3247786840-design/chenbai/微负压系统数学建模.md

# 微负压闭环气动系统 —— 数学建模报告

> 对象：硬件成本 <500 元的闭环微负压气动原型（非医疗器械，纯工程台架验证）
> 目标：正常维持 **15–20 mmHg**；任何单点/复合故障下，物理层将负压钳位在 **25 mmHg** 以内
> 方法：等温集总参数模型 + 解析设计定律 + 数值仿真（`model.py`，输出 `figs/*.png`）

---

## 1. 建模目标与范围

| 问题 | 建模回答 |
|---|---|
| 闭环能否把压力锁在 15–20 mmHg？ | 滞环与 PI-PWM 两种控制器的带内性能、泄漏负载下的占空比 |
| 四层防线是否数学上自洽？ | 每层给出触发条件的数学表达 + 故障注入仿真证据 |
| 三重灾难（MCU死机+继电器粘连+传感器短路）下 25 mmHg 红线是否守得住？ | 机械泄压阀的稳态钳位公式与选型反例 |
| 缓冲瓶"空间换容错"的定量收益？ | 时间定律 $t=V\Delta p/(P_{atm}Q)$ 及缓冲瓶选型曲线 |
| 断电/掉线后多快回到常压？ | 泄放时间常数与口径选型 |

不覆盖：生物学效应、人体实验、成本 BOM、PCB 实现。

---

## 2. 假设与符号

**假设**

1. **等温过程**：气路各处温度=环境温度。依据：腔体小、壁面换热快、压力变化率低（≤30 mmHg/s ≪ 1 atm/s），温升引起的附加压力 <1%。
2. **理想气体、集总参数**：每腔内压力瞬时均匀。依据：声速远快于控制时间尺度；罩杯↔缓冲瓶耦合时间常数 $\tau_{eq}\approx 1.8\ \text{ms}$（见 §4.2），远小于秒级控制动态。
3. **准稳态元件**：阀/泵/泄漏无动态（弹簧质量、电磁延迟 ≪ 控制周期）。
4. **表压表述**：$p$ 以大气压为零点，**负值=负压**；$|p|=20\ \text{mmHg}$ 即负压 20 mmHg。
5. 泵在微负压段（|p| ≤ 60 kPa ≪ 101.3 kPa）近似**恒体积流量**，仅在接近极限真空时线性降额。

**符号表**

| 符号 | 含义 | 基准值 |
|---|---|---|
| $P_{atm}$ | 大气压 | 101 325 Pa |
| $p$ | 表压（负=负压） | Pa |
| $V_c, V_b$ | 罩杯 / 缓冲瓶容积 | 0.3 L / 1 L |
| $Q_p$ | 泵抽速 | 3 L/min = 5×10⁻⁵ m³/s |
| $R_{cb}$ | 罩杯–缓冲瓶管路层流阻力 | 8×10⁵ Pa·s/m³（4 mm×30 cm） |
| $K_l$ | 密封泄漏孔口系数 | 1.614×10⁻⁸（标称 50 ml/min @ 20 mmHg） |
| $p_{crack}, K_r$ | 泄压阀起跳压力 / 流导 | 24 mmHg / 4.8×10⁻⁶ m³/(s·Pa^0.5) |
| $R_{vent}$ | 断电泄放路径阻力 | 6×10⁶ Pa·s/m³（τ≈77 ms） |
| $p_{ult}$ | 泵极限真空 | −60 kPa |
| 1 mmHg | — | 133.322 Pa |

---

## 3. 基础方程与元件模型

### 3.1 腔室压力动力学（核心方程）

由理想气体状态方程 $P_{abs}V=nRT$，等温下对时间求导：

$$V\frac{d(P_{atm}+p)}{dt}=RT\frac{dn}{dt}$$

把流入体积流量 $Q$（折算到大气密度，流入为正）换算为摩尔流量 $\dot n=\dfrac{P_{atm}}{RT}Q$，代入得**集总腔室方程**：

$$\boxed{\;V\frac{dp}{dt}=P_{atm}\sum Q_{in}\;}$$

物理含义：压力变化率 = 流量 × 大气压 / 容积——**容积越大，同样的泄漏/抽气引起的压力变化越慢**，这是全文所有"空间换时间"结论的根。

### 3.2 流阻与孔口

- 层流（管路耦合）：$Q=\Delta p/R$
- 孔口/湍流（泄漏、泄压阀、泄放）：$Q=K\sqrt{\Delta p}$（由 $Q=C_d A\sqrt{2\Delta p/\rho}$ 归并常数）

### 3.3 元件模型

**(a) 真空泵（恒流源 + 极限降额）**

$$Q_{pump}(p)=Q_p\cdot\max\!\Big(0,\;1-\frac{p}{p_{ult}}\Big),\qquad p_{ult}=-60\ \text{kPa}$$

**(b) 罩杯密封泄漏（空气漏入）**

$$Q_{leak}=\lambda\,K_l\sqrt{-p}\quad (p<0),\qquad \lambda=\text{泄漏劣化倍数}$$

标定：$\lambda=1$ 时 20 mmHg → 50 ml/min；$\lambda=8$（湿度/位移劣化）→ 400 ml/min。

**(c) 机械泄压阀（第四层，纯机械）**

$$Q_{relief}=\begin{cases}K_r\sqrt{-p-p_{crack}}, & -p>p_{crack}\\[2pt] 0,&\text{否则}\end{cases}$$

即：负压未达起跳压力时完全密封；起跳后按过压量平方根从大气吸入。

**(d) 常开电磁阀支路（三态）**

| 状态 | 条件 | 缓冲瓶支路流量 |
|---|---|---|
| 抽气 | 阀开 + 泵开（PWM 导通相） | $-Q_{pump}(p_b)$ |
| 密封 | 阀关（PWM 截止相，耗电保持） | $0$ |
| 泄放 | 断电 → 阀弹簧复位导通大气 | $-p_b/R_{vent}$ |

**常开=断电即泄放**在模型中的表达：任何"断电"事件把支路切到 `vent`，系统按 $\tau=R_{vent}V/P_{atm}$ 指数回零。

---

## 4. 系统状态方程

### 4.1 两腔模型（基准）

$$\frac{dp_c}{dt}=\frac{P_{atm}}{V_c}\Big[\frac{p_b-p_c}{R_{cb}}+Q_{leak}(p_c)+Q_{relief}(p_c)\Big]$$

$$\frac{dp_b}{dt}=\frac{P_{atm}}{V_b}\Big[-\frac{p_b-p_c}{R_{cb}}+u_{branch}(p_b)\Big]$$

控制量 $u_{branch}\in$ {抽气, 密封, 泄放}。传感器测量 $p_c$（因 $\tau_{eq}$ 极小，$p_b\approx p_c$，单传感器足够）。

无缓冲瓶时退化为单腔：$\dfrac{dp_c}{dt}=\dfrac{P_{atm}}{V_c}\big[Q_{leak}+Q_{relief}-u\cdot Q_{pump}\big]$。

### 4.2 耦合时间常数验证

$$\tau_{eq}=\frac{R_{cb}}{P_{atm}\big(\tfrac{1}{V_c}+\tfrac{1}{V_b}\big)}=\frac{8\times10^5}{101325\times4333}\approx1.8\ \text{ms} \ll \text{控制周期}$$

→ 集总假设成立，双腔模型数值稳定要求 $dt<2\tau_{eq}$，仿真取 **dt = 0.5 ms**。

---

## 5. 解析设计定律（模型最重要的输出）

### 5.1 时间定律：缓冲瓶到底买来多少抢救时间？

泵全速、忽略泄漏时压力线性下降，到某阈值 $\Delta p$ 的时间：

$$\boxed{\;t=\frac{V\,\Delta p}{P_{atm}\,Q_p}\;}$$

代入基准（$V_c+V_b=1.3$ L，$Q_p=3$ L/min，0→25 mmHg）：

| 配置 | 满流量降压速率 | 0→25 mmHg | 20→23（看门狗窗口） |
|---|---|---|---|
| **无缓冲瓶**（0.3 L） | 127 mmHg/s | **0.20 s** | 24 ms |
| **1 L 缓冲瓶**（1.3 L） | 29 mmHg/s | **0.86 s** | 103 ms |
| 1 L + 泵降速 1 L/min | 9.7 mmHg/s | 2.6 s | 0.31 s |
| 1 L + 泵降速 0.3 L/min | 2.9 mmHg/s | 8.6 s | 1.0 s |

> ⚠️ **对设计文档的重要修正**：1 L 缓冲瓶在 3 L/min 泵下的真实抢救时间是 **0.86 s，而非"数秒至数十秒"**（见 `fig6` 左图）。要兑现"数秒"，必须 **泵降速到 0.3–1 L/min**（首选，泄漏负载允许）或缓冲瓶加大到 ~5 L+。选型见 §9。
> 泵降速可行性校核：最恶劣泄漏 400 ml/min < 泵 1 L/min → 稳态占空比 40%，可行 ✓（若泵 <400 ml/min 则无法压制劣化泄漏，**密封质量与泵速是同一组约束**）。

舒适性推论：压力满速率仅 **29 mmHg/s**（1.3 L 时），压力变化平缓，皮肤拉扯感可控。

### 5.2 机械泄压阀钳位公式（第四层的定量表述）

泵全速 + 泄压阀全开时的稳态：$Q_p=Q_{leak}+Q_{relief}\approx Q_{relief}$，解出过压量：

$$\boxed{\;p_{clamp}=p_{crack}+\Big(\frac{Q_p}{K_r}\Big)^2\;}$$

**这是泄压阀选型的强制规范**：不是"起跳=25 就安全"，而是"起跳 + 全流量背压 ≤ 25"。

| 方案 | 起跳 | $K_r$ | 全流量背压 | 稳态钳位 | 判定 |
|---|---|---|---|---|---|
| **推荐** | 24 mmHg | 4.8×10⁻⁶ | 0.8 mmHg | **24.8** | ✓ 留 0.2 mmHg 余量 |
| 文档字面 | 25 mmHg | 2.5×10⁻⁶ | 3.0 mmHg | **27.5** | ✗ **越过红线** |
| 修正 | 23.5 mmHg | 2.5×10⁻⁶ | 3.0 mmHg | 26.5 | ✗ 仍越线 |
| 修正 | 23 mmHg | 4.8×10⁻⁶ | 0.8 mmHg | 23.8 | ✓ 但正常运行易误喷 |

仿真验证（`fig3`）：推荐方案钳位 **24.70 mmHg**，错误方案 **27.53 mmHg**，与解析值 24.8 / 27.5 吻合（差异来自泄漏分流）。
**★ 真实弹簧阀口径修订（`sim_upgrade.py` [B][C][D] 校核后）：**

1. 上式是"理想阀"口径（阀芯无惯性、开度瞬时到位）。加入弹簧-质量-阻尼阀芯后
   （`sim_upgrade.py` D 段，m=2 g、预压行程 x₀），两方程消元得**真实稳态过压**：

$$\overline{p}=\left(\frac{p_{crack}}{x_0/x_{max}}\cdot\frac{Q_p}{K_r\sqrt{p}}\right)$$

   现行 $K_r=4.8\times10^{-6}$（Ø2.8 阀座）在该口径下平衡点 = **27.8 mmHg > 25 越线**
   （数值 27.77 / 解析 28.09 双重确认，`fig10`）；要求全流量过压 ≤1 mmHg 需
   **$K_r\ge2.1\times10^{-5}$，推荐 $4.5\times10^{-5}$（Ø6–8 阀座）→ 钳位 24.4 ✓**，
   0.25 s 稳定、无颤振（阀芯固有频率 22–49 Hz ≫ PWM 2 Hz，无共振）。
2. 蒙特卡洛（N=20 000，起跳公差 ±0.5、$K_r$/泵速 ±10% 散布，`fig9`）：
   起跳 24.0±0.5 → 钳位 24.85±0.56，**P(>25)=39.2%**；
   收紧 **23.0±0.5 → 23.85±0.56，P(>25)=2.3%，P95=24.78**。
3. 因此定型规格修订为：**起跳 $p_{crack}=23.0\pm0.5$ mmHg + $K_r\ge2.1\times10^{-5}$**——
   弹簧公差与阀口流导必须联合校核，单看任一口径都会漏判。

### 5.3 泄漏负载 → 泵占空比

稳态占空比 $D=\lambda K_l\sqrt{|p|}/Q_p$：

| 工况 | 泄漏 @17.5 mmHg | 所需占空比（泵 3 L/min） |
|---|---|---|
| 标称密封 | 47 ml/min | **1.6%** |
| 劣化 ×8 | 374 ml/min | **12.9%** |

仿真（`fig2`）实测 1.6% / 12.9%，完全一致。**密封质量直接决定泵速下限**（见 §5.1）。

### 5.4 开环固定占空比为什么必然越线

满流量 29 mmHg/s ⇒ **PWM 开 1 s = 冲 29 mmHg**，从环境压出发约 0.82 s 穿看门狗 23、约 0.85 s 穿 24 mmHg：

- 电子防线健全：0.82 s 被看门狗截断（`fig5` 橙线）；
- 电子全失效：被机械阀锁在 24.7 mmHg 高位锯齿（`fig5` 红线）——**安全但长期处于危险区边缘**；
- 闭环截断脉冲：稳定 15–20（蓝线）。

结论：**"开1秒关3秒"只能作为闭环内的脉冲形状，绝不能作为开环固定节拍**——这在数学上支持了设计文档"开环必漂移"的判断，且比"漂移"更严重：是**单向冲顶**。

### 5.5 断电泄放时间常数

$$\tau=\frac{R_{vent}(V_c+V_b)}{P_{atm}},\qquad |p|(t)=|p_0|e^{-t/\tau}$$

选 $R_{vent}=6\times10^6$ → τ=77 ms → 从 17.5 mmHg 到 <1 mmHg 用时 **222 ms**（仿真 `fig4a` 实测 222 ms ✓）。
若要求"90% 泄放在 0.1 s 内"：$\tau\le43$ ms → $R_{vent}\le3.3\times10^6$ → 初始泄放峰值流量 48 L/min（等效通径 ~5 mm，1/4″ 常开阀即可满足）。

### 5.6 传感器短路的"隐身"与看门狗盲区

传感器短路读 −5 mmHg 恒值 → 第一、二层（都吃这个读数）**全部失效**，系统只能靠第四层。仿真（`fig3` 灰点划线）：真实压力 24.7 mmHg 时读数仍 5 mmHg，看门狗 `L2触发=False` ✓。
→ 防线设计推论：看门狗除阈值外必须做**合理性窗口检查**（如读数恒定方差≈0、或落在 −5~+5 mmHg 之外）；但即使看门狗被骗，**第四层不依赖任何电子量**。

---

## 6. 四层安全防线的数学表达

| 层 | 触发条件（数学） | 执行 | 故障注入仿真结果 |
|---|---|---|---|
| ① 软件闭环 | 滞环：$\|p\|\ge20$ 密封 / $\|p\|<15$ 抽气；或 PI：$u=\text{clip}(K_p e+K_i\!\int\! e)$，$e=17.5-\|p\|$ | PWM 截断脉冲 | 带内 15.00–20.05（滞环）、17.32–17.63（PI 标称），恶化后 15.00–20.04 / 16.39–18.66；见 `fig2` |
| ② 独立看门狗 | $\|p_{meas}\|>23$ 或传感器掉线/超量程 | 切断总电源 | 掉线 0.5 ms 内截断→213 ms 回常压（`fig4b`）；开环冲顶 820 ms 截断（`fig5`） |
| ③ 常开阀断电泄放 | 断电（任意原因）→ 支路切 `vent` | 弹簧复位导通大气 | τ=77 ms，222 ms 到 <1 mmHg（`fig4a`） |
| ④ 机械泄压阀 | $-p>p_{crack}=24$ mmHg，纯力学平衡 $F_{气}=F_{弹簧}$ | 大气强行涌入 | 复合灾难下钳位 24.70 mmHg < 25（`fig3`） |

**故障树（顶事件：罩杯 |p|>25 mmHg 持续）的最小割集**：

1. {继电器粘连 ∧ MCU 死机 ∧ 传感器短路} → 前三层全盲 → **仅④拦截：仿真钳位 24.70 ✓**（前提是 §5.2 选型规范，这是**强制项**）
2. {断电} → ③ 拦截：222 ms 回零 ✓
3. {传感器掉线} → ② 拦截：0.5 ms 截断 ✓
4. {开环固定占空比} → ①② 拦截，② 失效时 ④ 兜底 24.7 ✓，但属**设计违规**（禁止纯开环）

---

## 7. 数值仿真结果汇总

（`python model.py`，dt=0.5 ms，显式欧拉；参数=§2 基准）

| # | 场景 | 关键结果 |
|---|---|---|
| 1 | 正常滞环 + 120 s 泄漏×8 | 带内 **15.00–20.05**；占空比 1.6%→12.9%；看门狗未触发 |
| 2 | 正常 PI-PWM 同工况 | 标称 **17.32–17.63**；恶化后 **16.39–18.66** 仍在带内；占空比 1.7%→12.9% |
| 3 | 三重灾难（1 L 缓冲+合格阀） | 202 ms 到 23、**239 ms 到 24**、钳位 **24.70**；读数恒 5，看门狗隐身 |
| 4 | 三重灾难（无缓冲瓶） | **46 ms 到 23、55 ms 到 24**、钳位 24.70（④仍守住，但但②③已无时间反应） |
| 5 | 三重灾难（泄压阀选型错误） | 钳位 **27.53 > 25 ✗** → 证明 §5.2 规范的必要性 |
| 6 | 断电泄放 | τ=77 ms，**222 ms** 到 <1 mmHg |
| 7 | 传感器掉线 | 看门狗 **≤1 采样周期**截断，213 ms 到 <1 mmHg |
| 8 | 开环 1s/3s PWM，无电子防线 | **≈0.85 s 冲 24**，被机械阀锁在 22.5–24.7 锯齿（长期危险区边缘） |
| 9 | 开环 + 看门狗有效 | 820 ms 在 23 mmHg 截断回零 |
| 10 | 闭环对照 | 峰值 20.1，稳定带内 |

图表：`fig1` 拓扑与四层防线 · `fig2` 正常闭环 · `fig3` 灾难钳位 · `fig4` 断电/掉线 · `fig5` 开环危险性 · `fig6` 设计曲线。

---

## 8. 设计图表解读（fig6）

**左图（空间换时间定律）**：横轴总容积、纵轴 0→25 mmHg 时间（对数）。四条泵速曲线即 §5.1 表格的连续版。水平虚线 0.3 s = 看门狗可用窗口（100 Hz 采样）。基准点（1.3 L, 3 L/min）落在 0.86 s——高于窗口但**不足"数秒"**；把泵降到 1 L/min 即升到 2.6 s，落点即推荐设计。

**右图（泄压阀选型）**：三条起跳压力曲线随流导 $K_r$ 增大而逼近起跳值（背压→0）。红线 25 是硬约束：**任何曲线在设计点必须位于红线下方**。起跳 25 的曲线（红）永远压在红线上方→无解，只能把起跳降到 24（蓝曲线）并取 $K_r\ge4.8\times10^{-6}$。

---

## 9. 设计定型参数表

| 参数 | 定型值 | 依据 |
|---|---|---|
| 罩杯容积 $V_c$ | 300 ml | 题设 |
| 缓冲瓶 $V_b$ | **1 L**（下限 0.5 L） | 1.3 L 时 0.86 s；配合泵降速达"数秒" |
| 泵抽速 $Q_p$ | **0.5–1 L/min**（上限 3 L/min 时必须 100 Hz 看门狗） | §5.1 时间定律 + §5.3 泄漏压制 |
| 密封泄漏预算 | 标称 ≤50 ml/min @20 mmHg；必须容忍 ×8 劣化 | §5.3 占空比 13% 仍可行 |
| 泄压阀起跳 $p_{crack}$ | **23.0 ± 0.5 mmHg**（MC 校核：24±0.5 时 P(>25)=39%） | §5.2 真实阀+MC |
| 泄压阀流导 $K_r$ | **≥2.1×10⁻⁵，推荐 4.5×10⁻⁵（Ø6–8 阀座）**；4.8e-6 理想口径在动力学模型中钳位 27.8 越线 | §5.2 弹簧阀过压律 |
| 断电泄放 $R_{vent}$ | ≤6×10⁶（τ≤80 ms；要求 0.1 s/90% 则 ≤3.3×10⁶） | §5.5 |
| 看门狗 | 阈值 23 mmHg；采样 **≥100 Hz**；读数合理性窗口（防短路隐身） | §5.1/§5.6 |
| 控制器 | 滞环 15/20（简单可靠）或 PI（Kp=0.06, Ki=0.01, PWM 周期 0.5 s，脉冲按测量截断） | §7 场景 1–2 |
| 开环固定占空比 | **禁止** | §5.4 |

**安全结论**：在满足上表（尤其泄压阀两条强制规范——**规格已按 §5.2 真实阀口径与 MC 统计收紧：起跳 23.0±0.5、$K_r\ge2.1\times10^{-5}$**）的前提下，四层防线对所列全部故障组合提供冗余拦截；第 ④ 层不依赖任何电子量，是唯一在"三重灾难"下仍被仿真的防线，其钳位 24.70 mmHg（理想阀口径）/ 24.4 mmHg（真实阀口径）< 25 mmHg，且公式化了"为什么必须这么选型"。

---

## 10. 模型局限与后续工作（`sim_upgrade.py` 升级包已解决状态）

> 开源工具链：scipy `solve_ivp`(DOP853) / CoolProp 6.7.0 / numpy 蒙特卡洛 / 弹簧-阀芯动力学。

1. **等温假设 → ✅ 已量化**：CoolProp 实测全工况密度偏差 ≤0.50%（物性层成立）；
   双状态(质量+能量)热模型给出时间与漂移量级：泵故障到 24 mmHg 等温 239.5 ms vs
   绝热 171 ms（**等温偏保守 +29%，安全方向**）；密封相有限换热(τ=20s)热漂移
   **3.68 mmHg < 滞环预算 5 mmHg**，且泄漏同向进一步抵消（`fig8`）。
2. **泵特性 → ⚠ 仍建议实测**：恒流+线性降额近似保留；厂家 P-Q 曲线到位后替换
   `pump_flow()` 即可，其余结论对 Q 敏感度已由 MC 给出（±10% → 钳位 σ0.56 mmHg）。
3. **泄压阀动态 → ✅ 已建模并修订规格**：弹簧-质量-阻尼+开度流量耦合（`fig10`），
   0.25–0.62 s 稳定、无颤振、PWM 2 Hz ≪ 阀芯 22–49 Hz；**发现理想阀口径漏判**
   （真实平衡 27.8>25）→ §5.2/§9 规格已修订（K_r≥2.1e-5、起跳 23.0±0.5）。
4. **湍流/层流分区**：孔口律统一处理，低压差略偏保守（偏安全），保留。
5. **多物理耦合**：管路柔度未建模（实际更"慢"→偏安全），保留。
6. **传感噪声/统计 → ✅ 已纯仿真关闭**：MC 10k 覆盖起跳公差×流导×泵速×容积散布
   （`fig9`）：现行规格 P(>25)=**39.2%** → 收紧后 2.3%；看门狗窗口 3 L/min 有
   39.8% 概率 <100 ms、1 L/min 为 0%。噪声×量化×零漂抖振扫描（E 段，100ms
   节拍与固件一致）：基准/σ0.38/量化2.0/零漂1.0 各工况真值带 ≤22.6、启停次数
   与基准同量级 → 滞环鲁棒；单样本 σ0.94 出现罕见双误差毛刺顶到 ~24.5
   （触 L4 而非越 25），固件 16 点平均 σ÷4≈0.24 后消除 → **滤波为强制项**。
7. **数值自证 → ✅ 已交叉验证**：欧拉(dt=0.5 ms) vs scipy DOP853(rtol=1e-9)
   轨迹最大偏差 **0.41 Pa**，到 24 mmHg 时间与钳位完全一致 → 既有结果可信。
8. **可移植性**：`model.py` 纯 numpy 显式积分，可直接翻译为 MATLAB 或 C
   （MCU 端在环仿真）。

---

## 附录 A：复现方式

```bash
cd <本项目根目录>       # 克隆后切换到仓库根（含 model.py 的那一层）
python model.py        # 输出指标表 + figs/fig1..7
python sim_upgrade.py  # 升级包：交叉验证/热力学/MC/阀动态 → figs/fig8..10
```

依赖：Python ≥3.8，numpy、scipy、matplotlib（中文使用 Microsoft YaHei）；
可选 CoolProp ≥6.7（物性权威来源，缺失时回退其 300K 权威值）。

## 附录 B：关键公式速查

| 公式 | 用途 |
|---|---|
| $V\,dp/dt=P_{atm}Q$ | 一切压力动态的根 |
| $t=V\Delta p/(P_{atm}Q)$ | 缓冲瓶/泵速选型 |
| $p_{clamp}=p_{crack}+(Q_p/K_r)^2$ | 泄压阀起跳+流导选型 |
| $D=\lambda K_l\sqrt{|p|}/Q_p$ | 泵速下限 |
| $\tau=R\,V/P_{atm}$ | 断电泄放口径 |
| $\tau_{eq}=R_{cb}/[P_{atm}(1/V_c+1/V_b)]$ | 集总模型有效性 |
