3247786840-design/chenbai/通气实验方案.md

# 通气实验方案（台架版）

> **性质与红线**：本方案仅用于**台架通气验证**（密封气球 / 硅胶假体 / 注水模拟皮肤）。
> 严禁人体接触、严禁佩戴测试、严禁在无人看管下运行任何"故障注入"步骤（S3/S4/S6）。
> 判定基准为**仿真预测值**（`model.py` / `buffer_sweep.py` / `sim_upgrade.py`，已经
> scipy 独立求解器交叉验证）；容差按仪表分辨率与实测抽速不确定性给出，见各步注明。
> 记录表中的"实测"列在硬件到位后回填，最终与 README 台架数据表互相引用。

---

## 0. 器材与仪表

| 类别 | 清单 | 备注 |
|---|---|---|
| 被测件 | 打印件（转接头/瓶盖/外壳）、500ml 瓶、Ø80 硅胶罩杯、内4外6 医用硅胶管、常开电磁阀、微型真空泵、微差压传感器、机械泄压阀(起跳按 §9 修订规格 23.0±0.5)、ESP32 固件已烧录 | 打印材料仅限医用树脂/PETG |
| 仪表 | **机械真空表 0~-60 kPa（主判定表）**、电子数显负压表（辅助/记录）、秒表或手机 120fps 慢动作（计时）、温度计 | 机械表独立于被测电子链，是 S3/S4 的法定读数源 |
| 台架 | 密封气球/注水假体、亚克力隔离罩（故障注入步骤用）、急停断电开关、扎带/夹具 | 急停直接断泵继电器电源 |
| 记录 | 本文件记录表 + 原始数据截图/照片 | 每步留存原始数据 |

**通用条件**：室温 20–26 ℃；每步开始前设备静置 ≥5 min；每步之间断电复位回零。

---

## S0. 实测自标定（先做，用于修正后续所有时间判据）

**目的**：仿真时间公式 `t = V·Δp /(P_atm·Q)` 中 Q 是名义值（3 L/min），先实测。

**步骤**：
1. 泵直连机械表 + 量筒排水法（或秒表+流量计）测抽速：记录 60 s 内抽气水量 V_w；
   `Q_meas = V_w / 60 s`（换算到 L/min）。
2. 记录泵极限真空（堵死抽 30 s 读表）：应 ≈ **-60 kPa**。

**记录表**

| 项 | 名义值 | 实测 | 备注 |
|---|---|---|---|
| Q_p [L/min] | 3.0（或 0.5–1 规格） | | |
| 极限真空 [kPa] | -60 | | |

**后续时间类判据统一修正**：`t_预测 = t_表中值 × (3.0 / Q_meas)`。

---

## S1. 静态检漏

**步骤**：按装配图接好全气路（罩杯端封堵），泵抽至 **-40 kPa**，停泵关阀，静置 **60 s** 读表。

| 项 | 判据（来源） | 实测 | 判定 |
|---|---|---|---|
| 60 s 压降 | **< 1 kPa**（瓶盖装配说明/管路密封） | | ☐PASS ☐FAIL |
| 起始/终止读数 | 记录 | | |

---

## S2. 零点、量程与断电泄放

| 项 | 步骤摘要 | 判据（来源） | 实测 | 判定 |
|---|---|---|---|---|
| 大气零点 | 未抽气读电子+机械表 | **0 ± 1 mmHg**（FMEA B 节） | | ☐ |
| 断电泄放 | 抽至 -20 mmHg，运行中**拔总电**，慢动作计时 | 17.5→<1 mmHg：**≈222 ms**（τ≈77 ms，`fig4a`）；判据 **≤ 500 ms** | | ☐ |
| 常开阀确认 | 断电后阀位 | 必须通大气（断电=开），无残余负压 | | ☐ |

---

## S3. 泄压阀起跳与稳态钳位 ⚠ 故障注入（隔离罩内做）

**步骤**：出口全封、泵全速强抽，**以机械表为唯一法定读数**，用慢动作录像读起跳压力与平台；
重复 3 次取均值。每次后断电复位。

| 项 | 判据（来源） | 实测1/2/3 | 均值 | 判定 |
|---|---|---|---|---|
| 起跳压力 | **23.0 ± 0.5 mmHg**（§9 修订规格；MC 校核 P(>25)=2.3%） | | | ☐ |
| 稳态钳位 | **≤ 25 mmHg**，预测 **24.4**（`fig10`，K_r=4.5e-5 阀座 Ø6–8） | | | ☐ |
| 开阀稳定时间 | **≤ 1 s** 无持续颤振（预测 0.25 s） | | | ☐ |
| 若实测钳位 >25 | 判 FAIL → 阀座流导不足（§5.2 真实阀过压律），换阀重测 | | | |

---

## S4. 泵故障时限 ⚠ 故障注入（隔离罩内做）

**步骤**：模拟"死机+继电器粘连"：强电直连使泵持续全速，从 -17.5 mmHg 起计时（慢动作 120fps）。

| 项 | 判据（来源）×S0 修正 | 实测 | 判定 |
|---|---|---|---|
| 20→23 mmHg（看门狗窗口） | 3 L/min：**104 ms**（1L 瓶）；1 L/min：**311 ms**。`fig9` 显示 3 L/min 有 39.8% 概率 <100 ms → **若 Q_meas>2.5 L/min，必须泵侧节流或换 ≤1 L/min 泵** | | ☐ |
| 0→25 mmHg（无缓冲瓶） | **≈0.24 s ×修正**（`buffer_sweep`） | | ☐ |
| 0→25 mmHg（1L 缓冲瓶） | **≈0.86 s ×修正** | | | ☐ |
| 终点 | 被 S3 的泄压阀钳住，**不越过 25** | | ☐ |

---

## S5. 闭环带性能（正常工况）

**步骤**：正常供电闭环运行 10 min；随后注入泄漏（松开一处接头半圈）模拟 ×8 劣化再跑 10 min。
电子表记录全曲线。

| 项 | 判据（来源） | 实测 | 判定 |
|---|---|---|---|
| 标称带内 | **15.0–20.05 mmHg**（滞环，`fig2a`） | | ☐ |
| 泵占空比（标称） | **≈1.6%** | | ☐ |
| 泄漏×8 后带内 | **15.0–20.05 mmHg**，占空比 **≈12.9%** | | ☐ |
| 看门狗误触发 | **0 次** | | ☐ |
| PI 模式（可选） | 标称 17.3–17.6；×8 后 16.4–18.7（`fig2b`） | | ☐ |

---

## S6. 电子故障注入 ⚠（隔离罩内做）

| 项 | 注入方法（无需改固件） | 判据（来源） | 实测 | 判定 |
|---|---|---|---|---|
| 传感器掉线 | 拔传感器插头 | **≤1 采样周期**截断→断电泄放，回到 <1 mmHg **≈213 ms**（`fig4b`），红灯慢闪 | | ☐ |
| 传感器短路（读低） | 信号线短接到地（读值恒低） | 看门狗被"隐身"→ 压力下行由 **S3 泄压阀钳住 ≤25**（`fig3` 灰线场景），事后检查红灯不应报看门狗 | | ☐ |
| 软件超压截断 | 手动加压到 -23（注射器/微泵） | **≤-23 触发断电泄放**，红灯快闪 | | ☐ |
| 继电器粘连模拟 | 触点并线常供电 | 泵不停 → 走 S4 判据，最终由泄压阀钳位 | | ☐ |
| 硬中断脚 | 比较器输出拉低（若已装 LM393） | **≤-25 立即停泵开阀**（ISR，无延迟） | | ☐ |

---

## S7. 长时保压与热漂移

**步骤**：闭环稳定在 -20 mmHg 后密封运行 **30 min**（室温恒定），记录压力曲线。

| 项 | 判据（来源） | 实测 | 判定 |
|---|---|---|---|
| 漂移幅度 | 热漂移 **≤3.7 mmHg**（τ=20s 模型，`fig8b`）+ 泄漏同向 → 总漂移应 **≤5 mmHg**（滞环预算） | | ☐ |
| 是否触发重抽 | 漂到 -15 自动恢复带内 | | ☐ |
| 30 min 内看门狗 | **0 次** | | ☐ |

---

## 仿真 → 实测总对照表（完成后回填 README）

| 台架数据表行 | 仿真预测 | 实测 | 偏差 | 备注 |
|---|---|---|---|---|
| 0/500/2000ml 到 -25 时间 | 0.24 / 0.65 / 1.87 s | | | ×(3/Q_meas) 修正 |
| 断电泄放 | 222 ms | | | |
| 泄压阀起跳 | 23.0±0.5 | | | |
| 稳态钳位 | 24.4 | | | 必须 ≤25 |
| 闭环带 | 15.0–20.05 | | | |
| 占空比 标称/×8 | 1.6% / 12.9% | | | |
| 看门狗窗口 3L/1L | 104 / 311 ms | | | |

---

## 异常处置与禁止事项

1. **急停**：任何步骤中机械表 >25 mmHg 持续、异响、冒烟 → 拉急停（直接断泵电源），套用
   FMEA 生存指南。
2. 故障注入步骤必须在**亚克力隔离罩内**、有人值守、单次 ≤3 min。
3. 禁止：堵死泄压阀做实验、拆除泄压阀"试极限"、任何人体/皮肤接触、无人值守抽气。
4. 每次改版（气路/阀/泵/固件任一变更）→ 重跑受影响步骤并更新本表与 README。

---

*版本 v1.0（对应仿真 ver. 与修订后规格：起跳 23.0±0.5、K_r≥2.1e-5、泵≤1 L/min 建议）*
