3247786840-design/chenbai/figs/fig1_topology.png

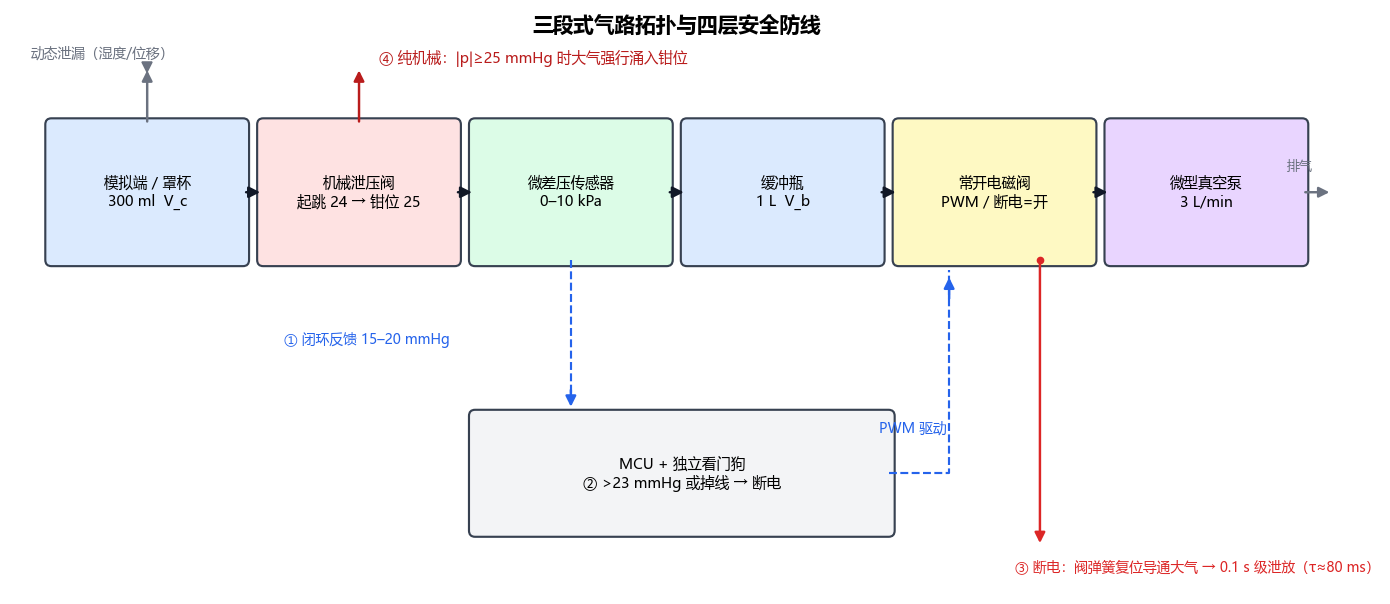
figs/fig1_topology.png
