3247786840-design/chenbai/figs/fig3_fault.png

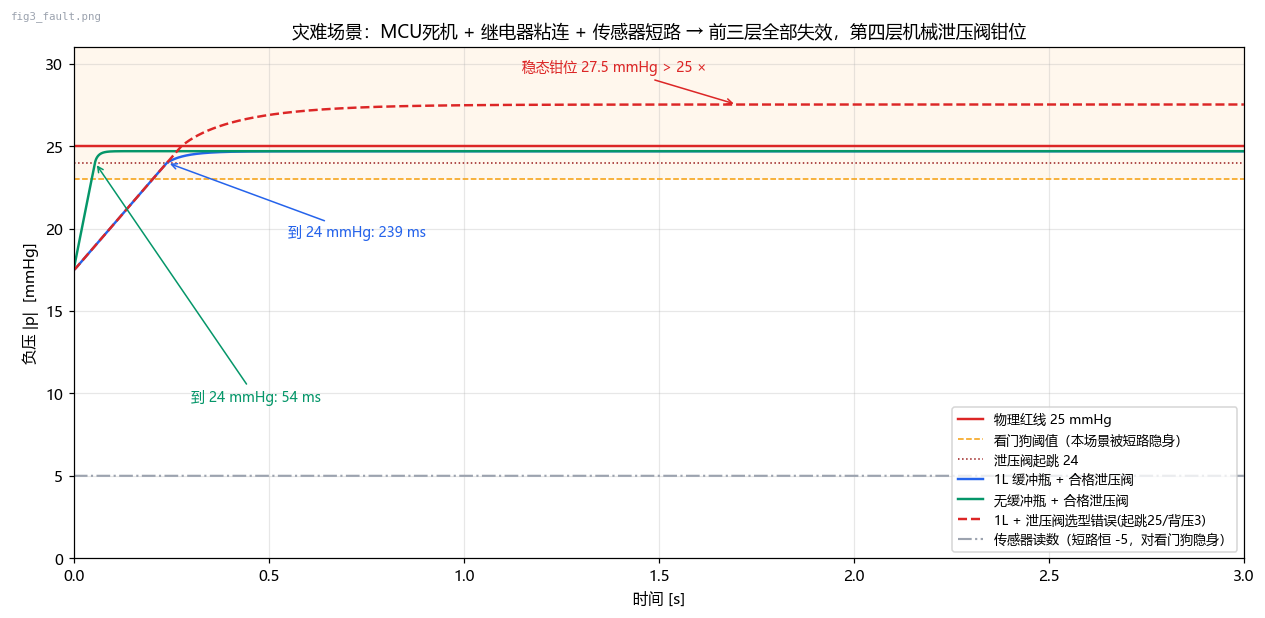
figs/fig3_fault.png
