3247786840-design/chenbai/figs/fig4_power_dropout.png

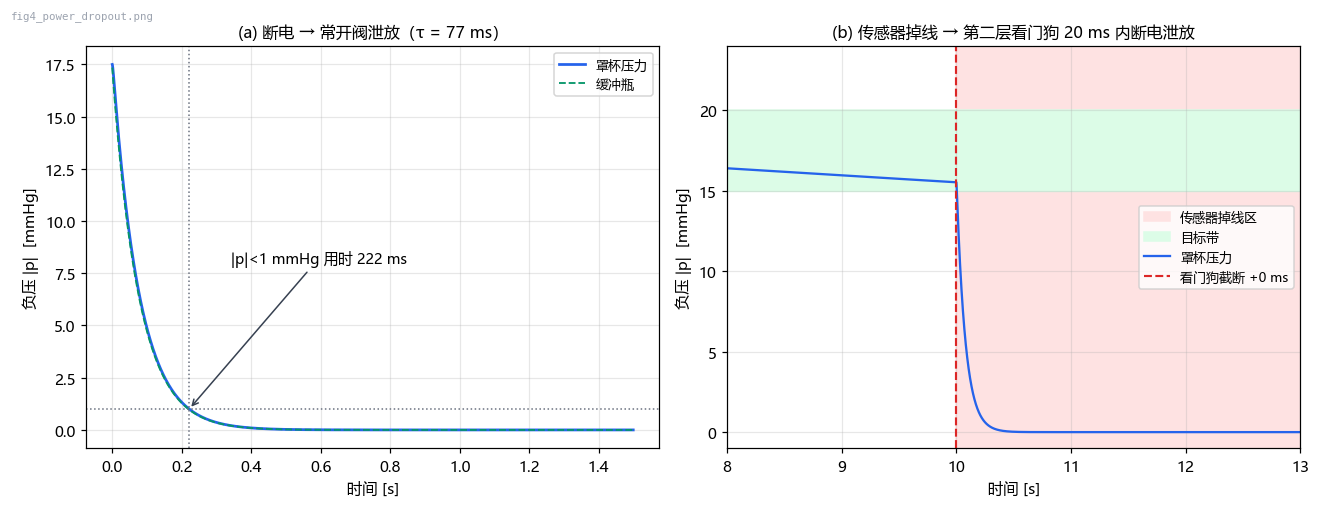
figs/fig4_power_dropout.png
