3247786840-design/chenbai/figs/fig5_pwm.png

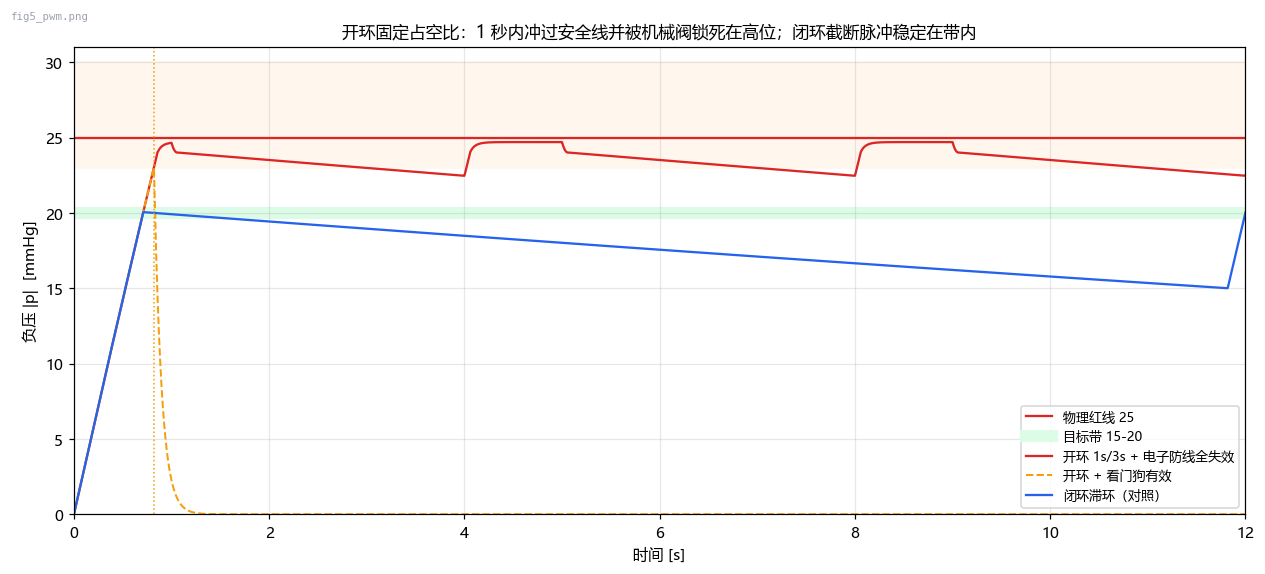
figs/fig5_pwm.png
