3247786840-design/chenbai/figs/fig6_design.png

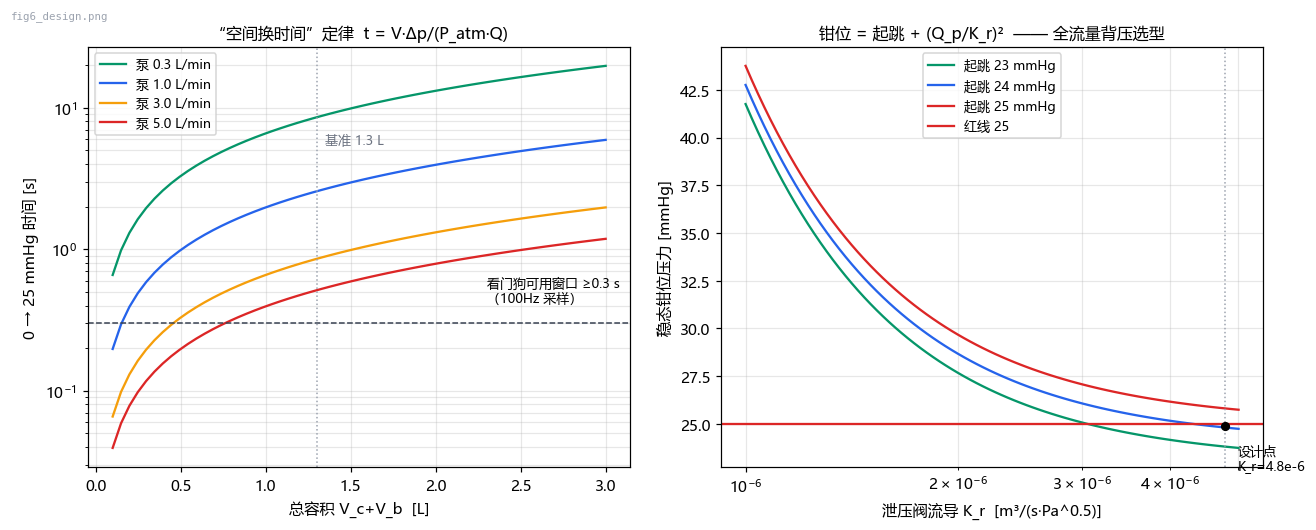
figs/fig6_design.png
