3247786840-design/chenbai/figs/fig8_thermal.png

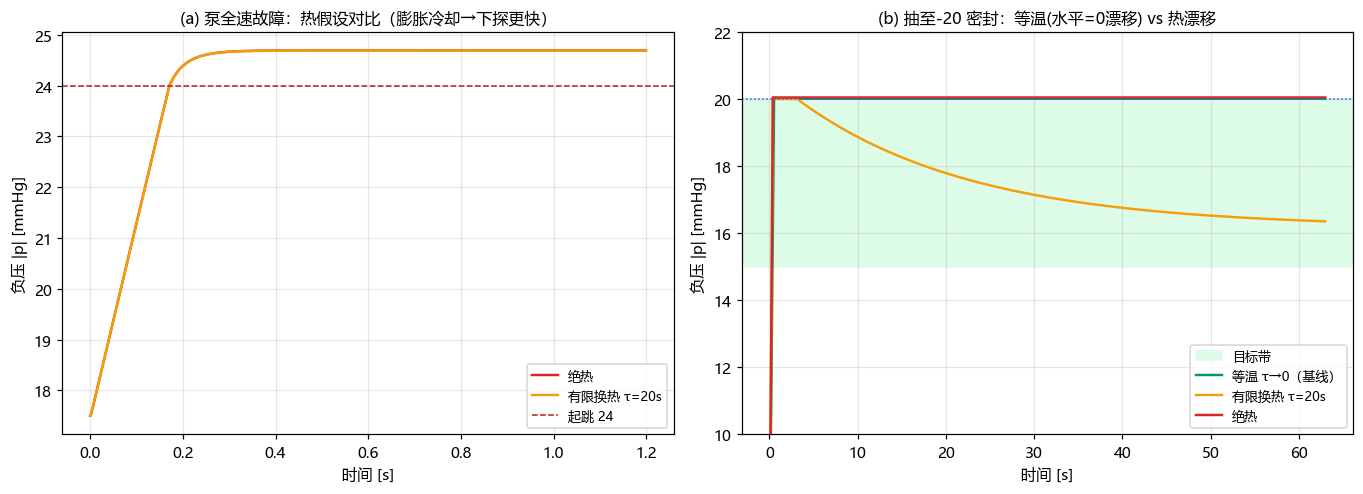
figs/fig8_thermal.png
