3247786840-design/chenbai/figs/fig9_mc.png

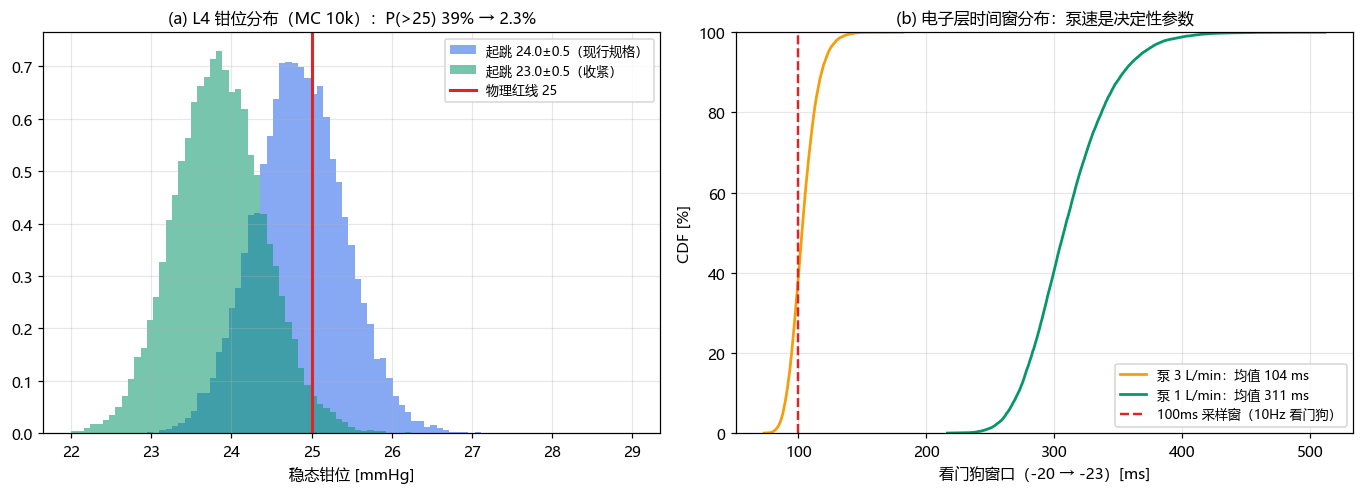
figs/fig9_mc.png
