3247786840-design/chenbai/figs/fig10_valve.png

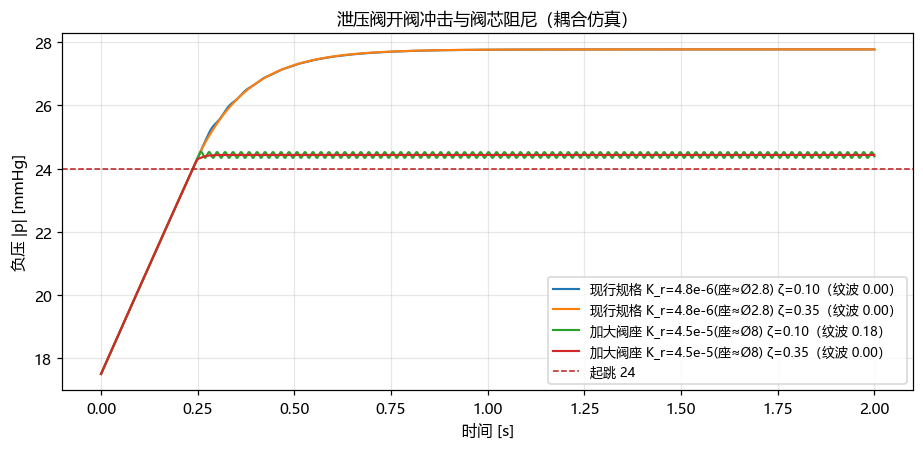
figs/fig10_valve.png
