3247786840-design/chenbai/stl/angles_sheet.png

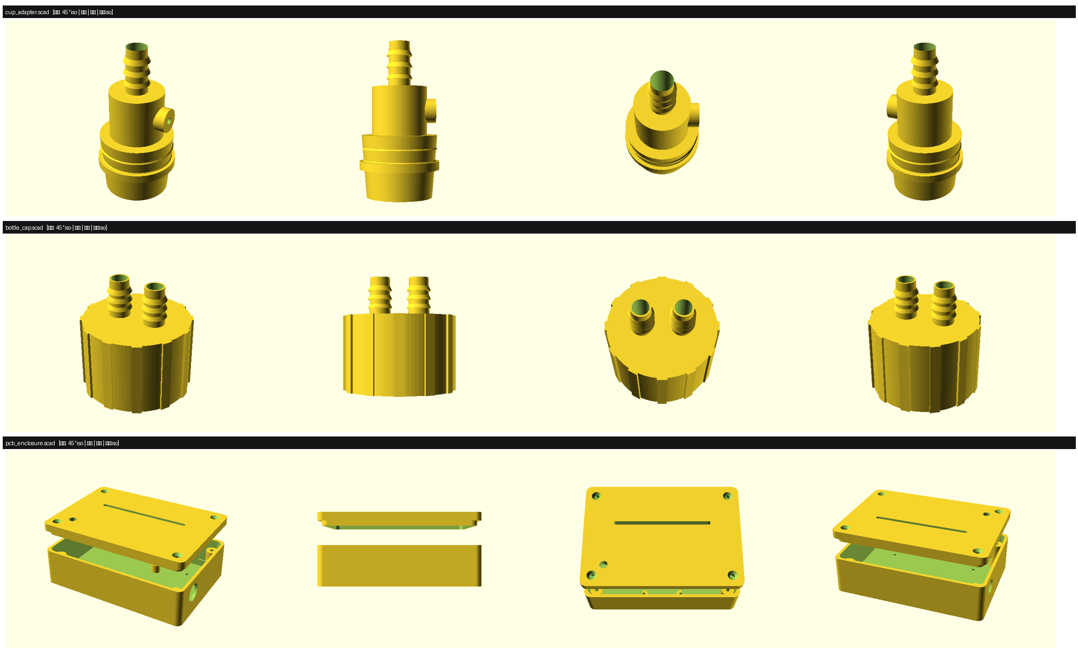
stl/angles_sheet.png
