3247786840-design/chenbai/stl/views/bottle_cap_front.png

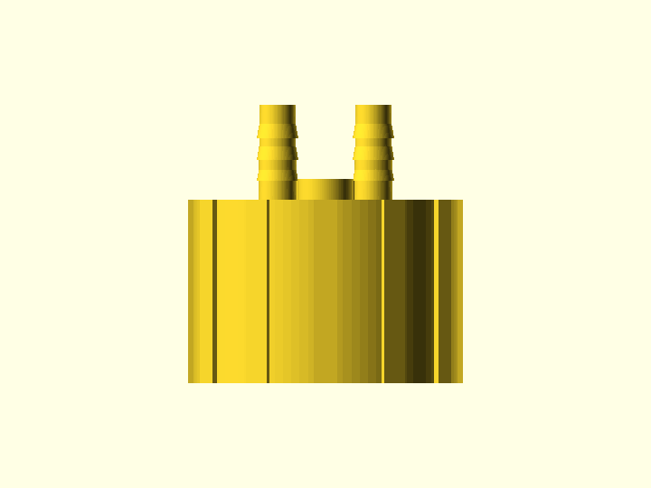
stl/views/bottle_cap_front.png
