3247786840-design/chenbai/stl/views/bottle_cap_iso.png

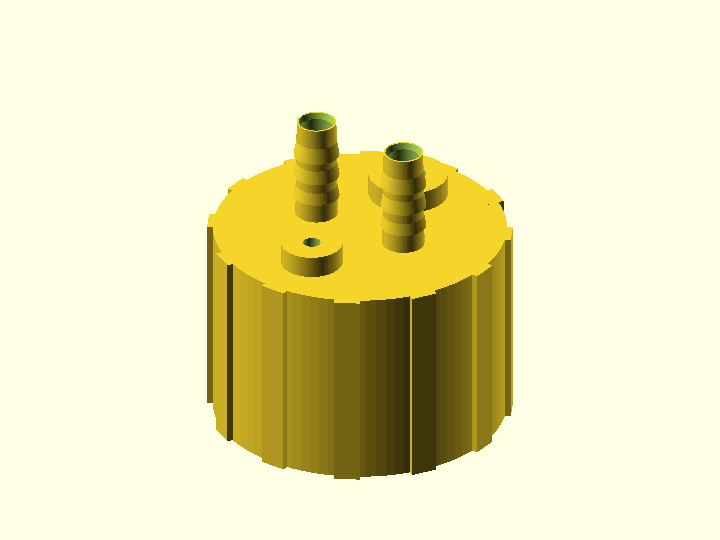
stl/views/bottle_cap_iso.png
