3247786840-design/chenbai/stl/views/bottle_cap_side.png

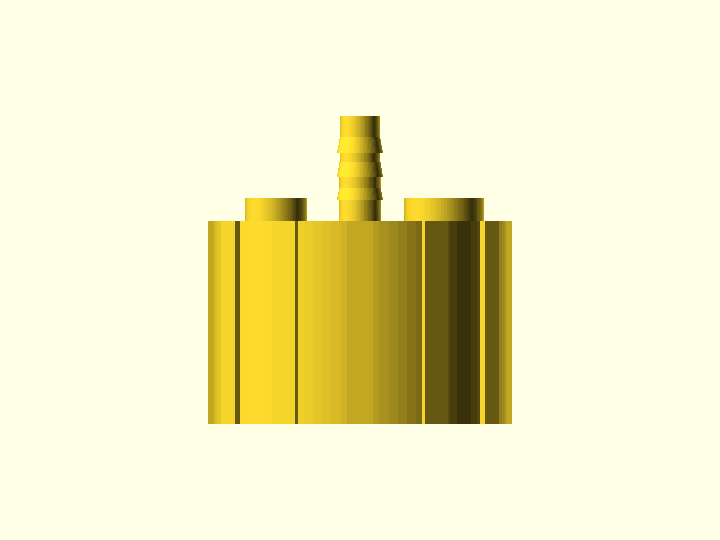
stl/views/bottle_cap_side.png
