3247786840-design/chenbai/stl/views/bottle_cap_top.png

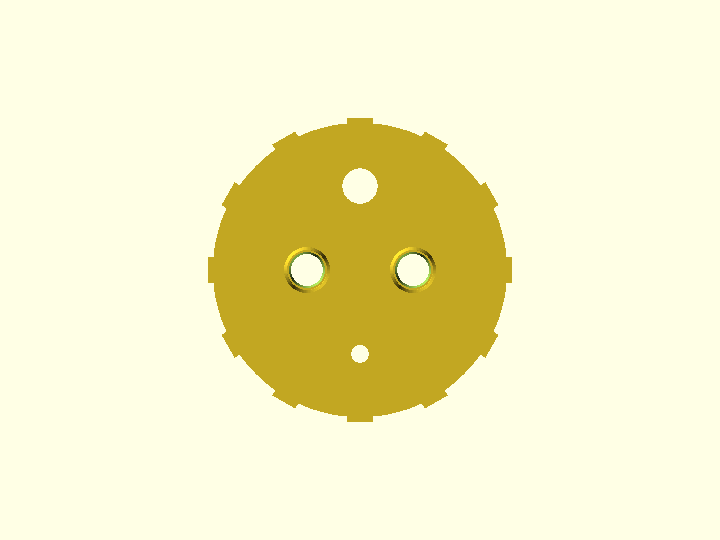
stl/views/bottle_cap_top.png
