3247786840-design/chenbai/stl/views/cup_adapter_front.png

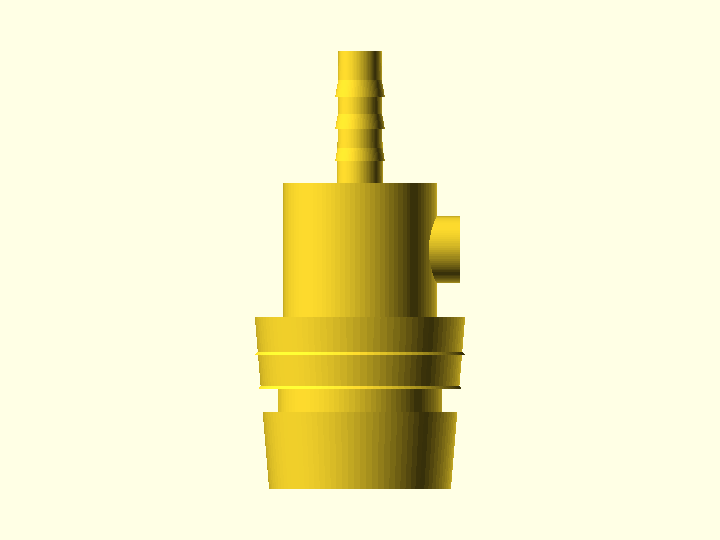
stl/views/cup_adapter_front.png
