3247786840-design/chenbai/stl/views/cup_adapter_iso.png

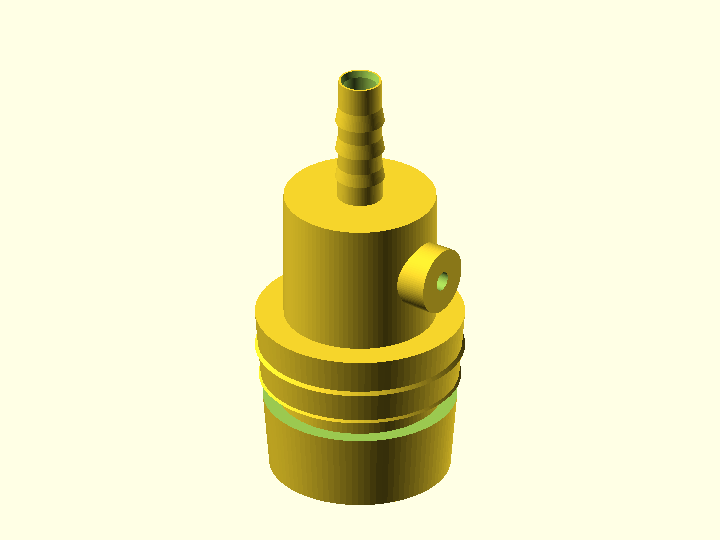
stl/views/cup_adapter_iso.png
