3247786840-design/chenbai/stl/views/cup_adapter_top.png

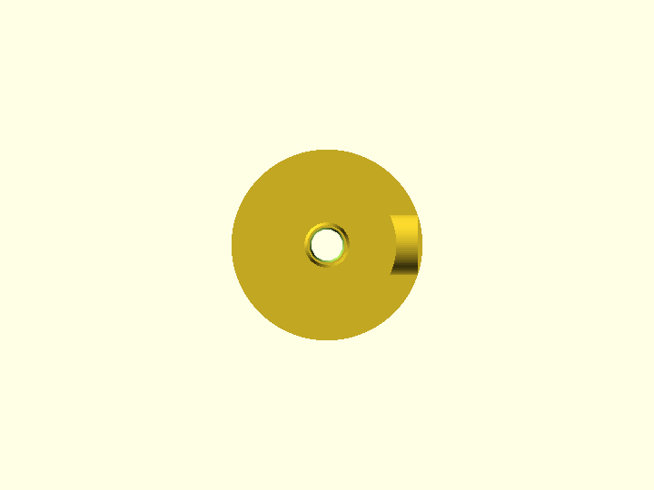
stl/views/cup_adapter_top.png
