3247786840-design/chenbai/stl/views/pcb_enclosure_front.png

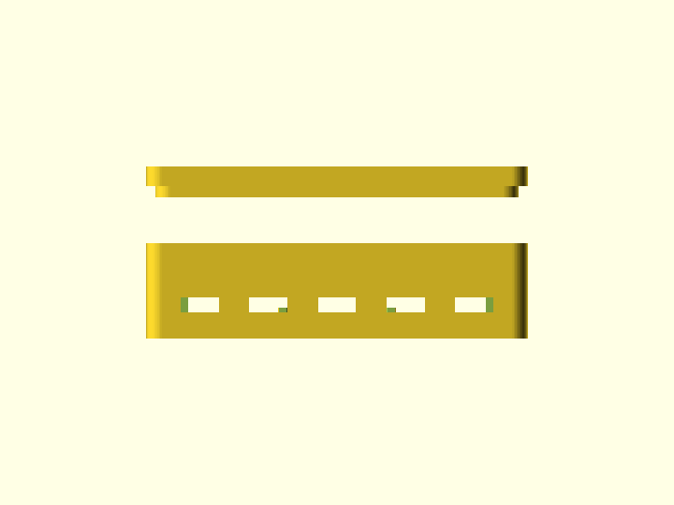
stl/views/pcb_enclosure_front.png
