3247786840-design/chenbai/stl/views/pcb_enclosure_iso.png

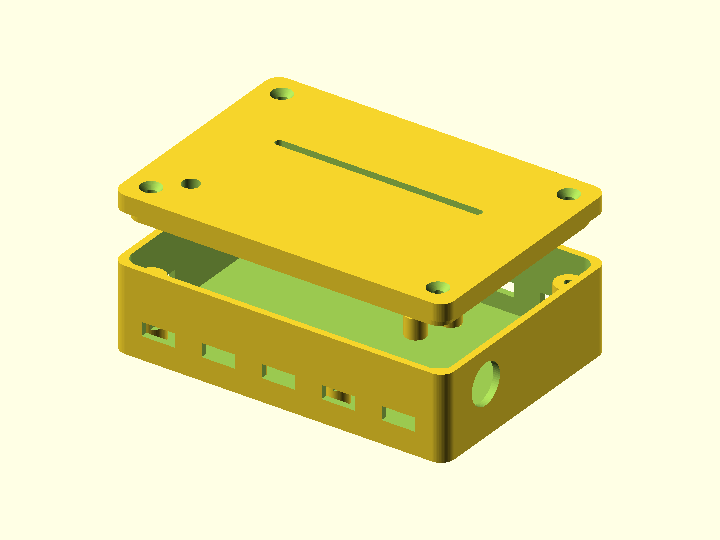
stl/views/pcb_enclosure_iso.png
