3247786840-design/chenbai/stl/views/pcb_enclosure_side.png

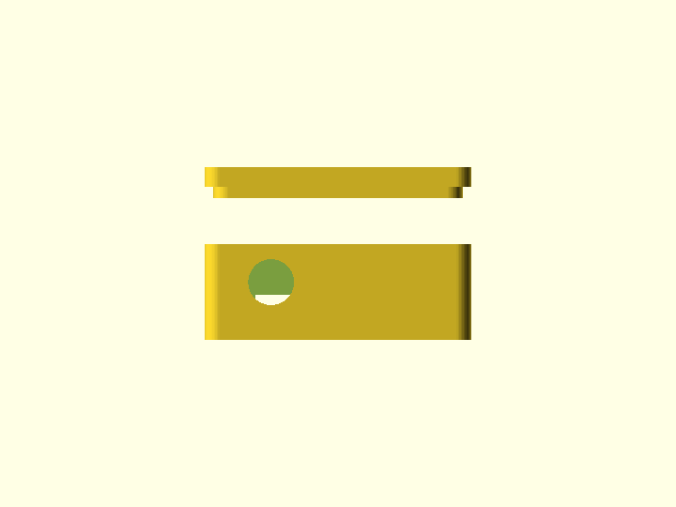
stl/views/pcb_enclosure_side.png
