3247786840-design/chenbai/stl/views/pcb_enclosure_top.png

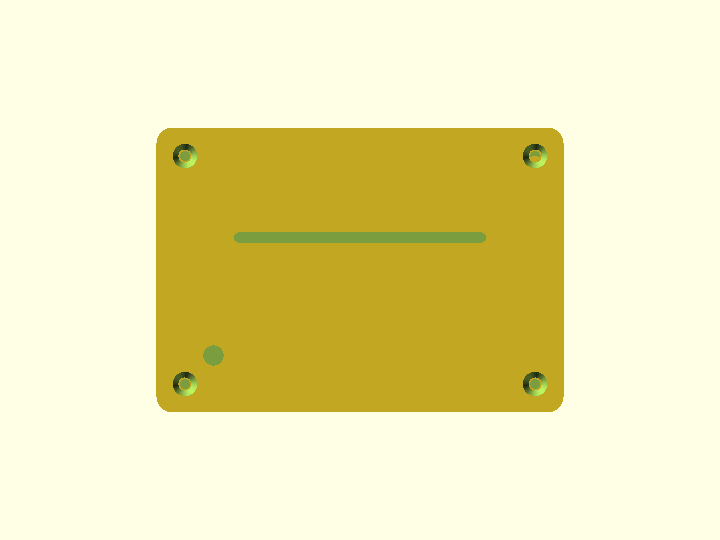
stl/views/pcb_enclosure_top.png
