3247786840-design/chenbai/stl/views/sheet_bottle_cap.png

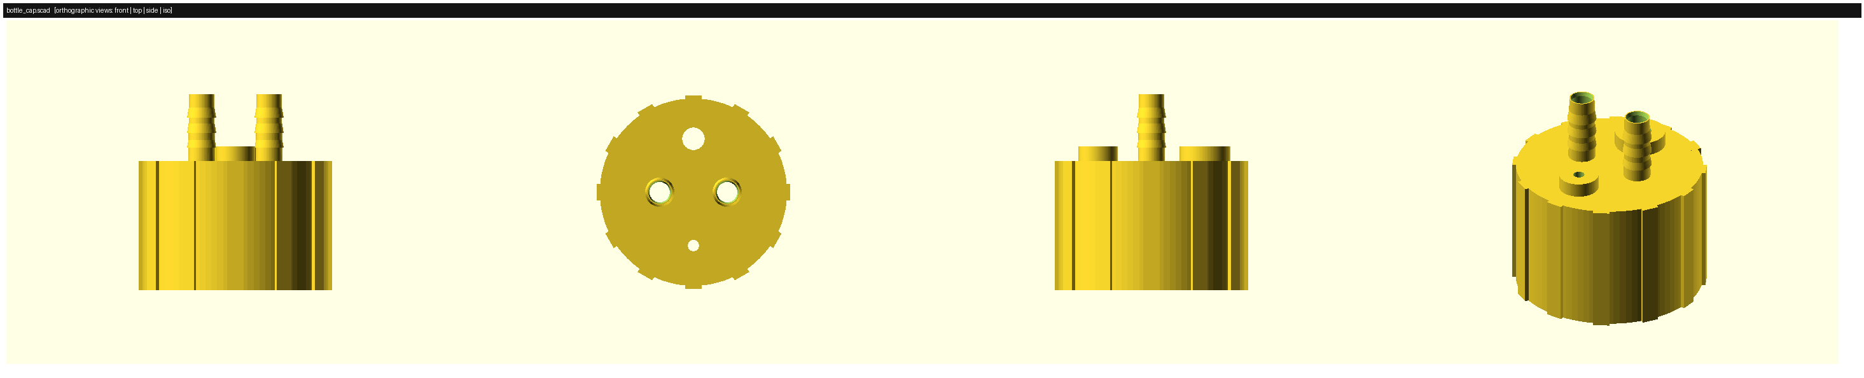
stl/views/sheet_bottle_cap.png
