3247786840-design/chenbai/stl/views/sheet_cup_adapter.png

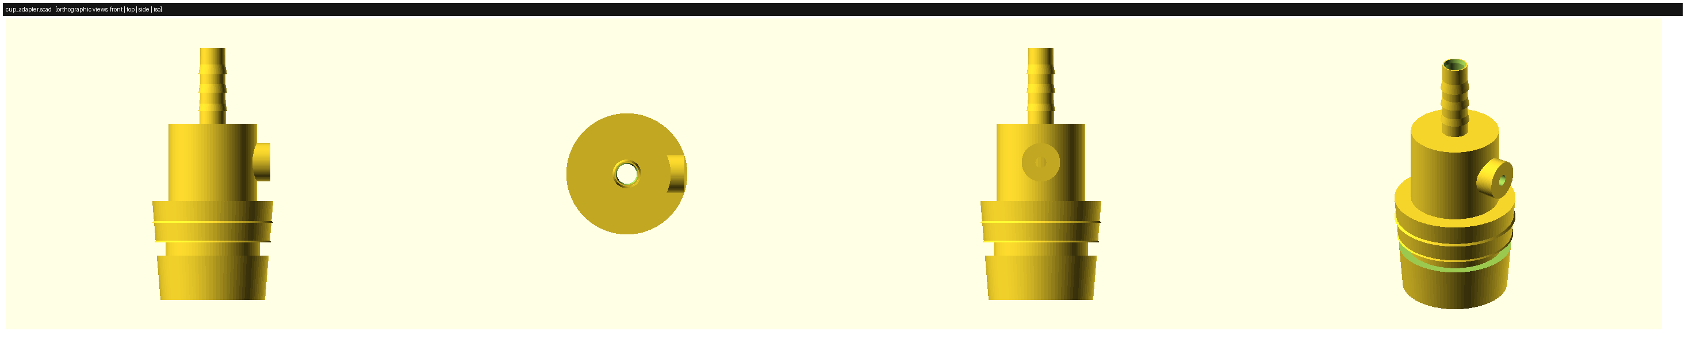
stl/views/sheet_cup_adapter.png
