3247786840-design/chenbai/stl/views/sheet_pcb_enclosure.png

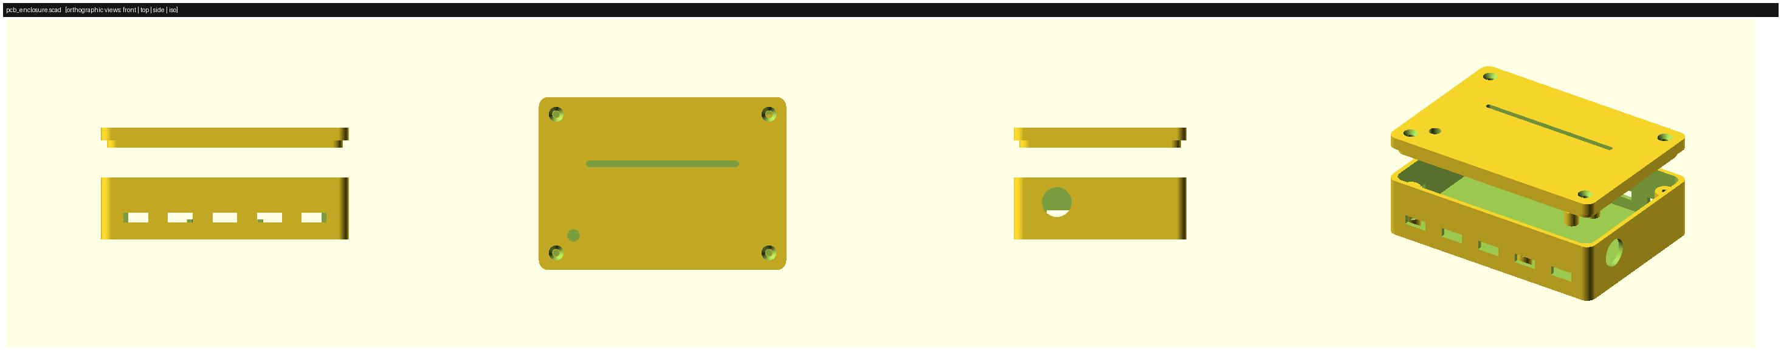
stl/views/sheet_pcb_enclosure.png
