3247786840-design/chenbai/stl/cup_adapter.stl

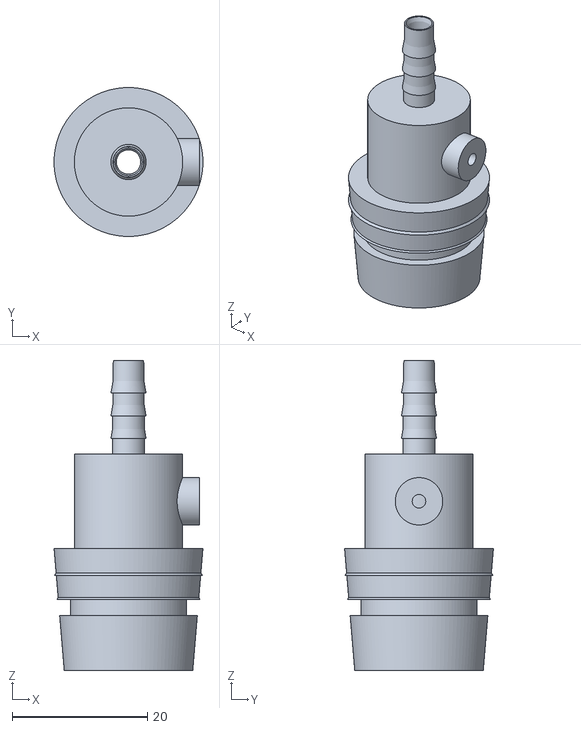
[picture p26: CAD file, 2026-10-03]
stl/cup_adapter.stl
22.0 x 22.0 x 45.8
