3247786840-design/chenbai/stl/bottle_cap.stl

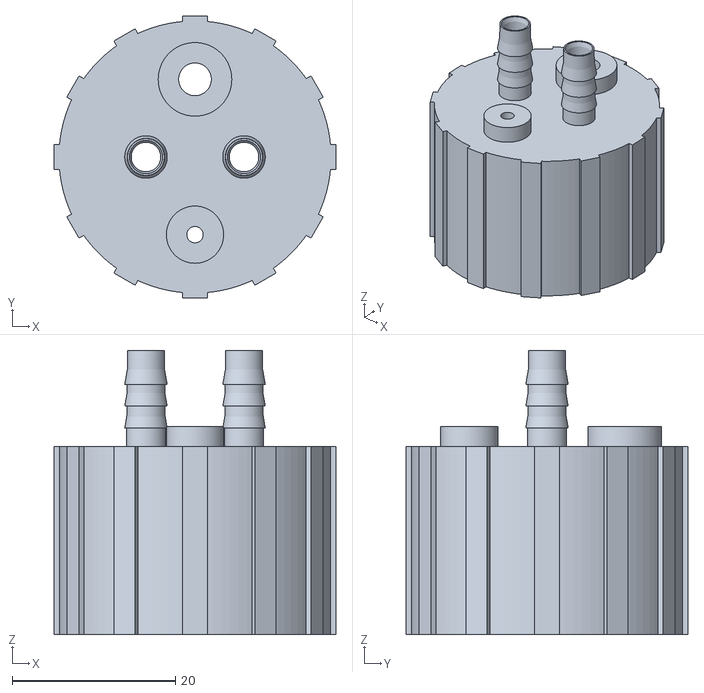
[picture p27: CAD file, 2026-10-03]
stl/bottle_cap.stl
34.5 x 34.5 x 34.8
