3247786840-design/chenbai/stl/pcb_enclosure.stl

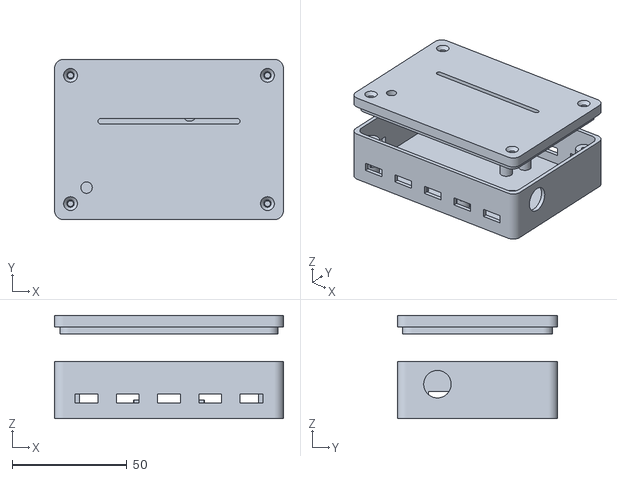
[picture p28: CAD file, 2026-10-03]
stl/pcb_enclosure.stl
100.0 x 70.0 x 45.0
