3247786840-design/chenbai/stl/system_assembly_v2.png

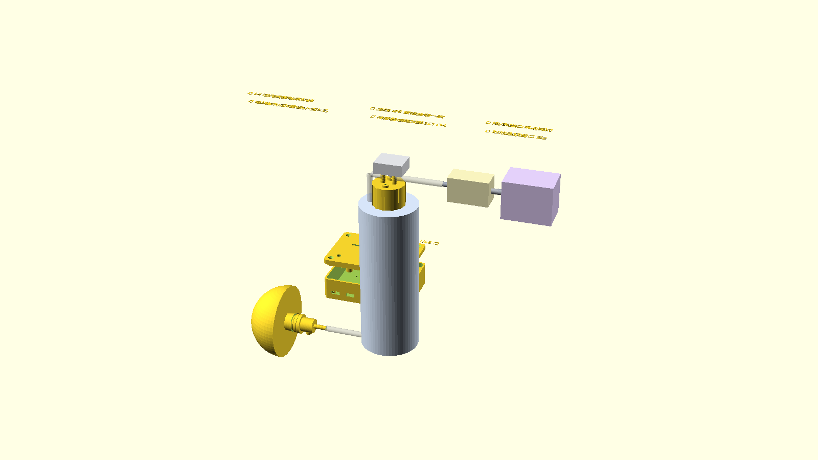
stl/system_assembly_v2.png
