3247786840-design/chenbai/stl/views/sheet_system_assembly.png

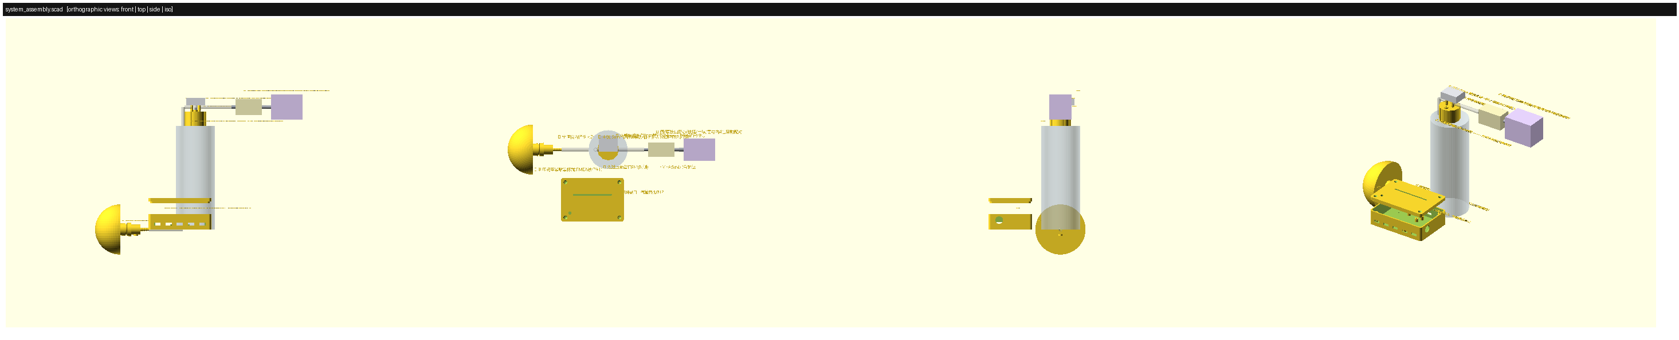
stl/views/sheet_system_assembly.png
