3247786840-design/chenbai/stl/views/sheet_system_assembly_v2.png

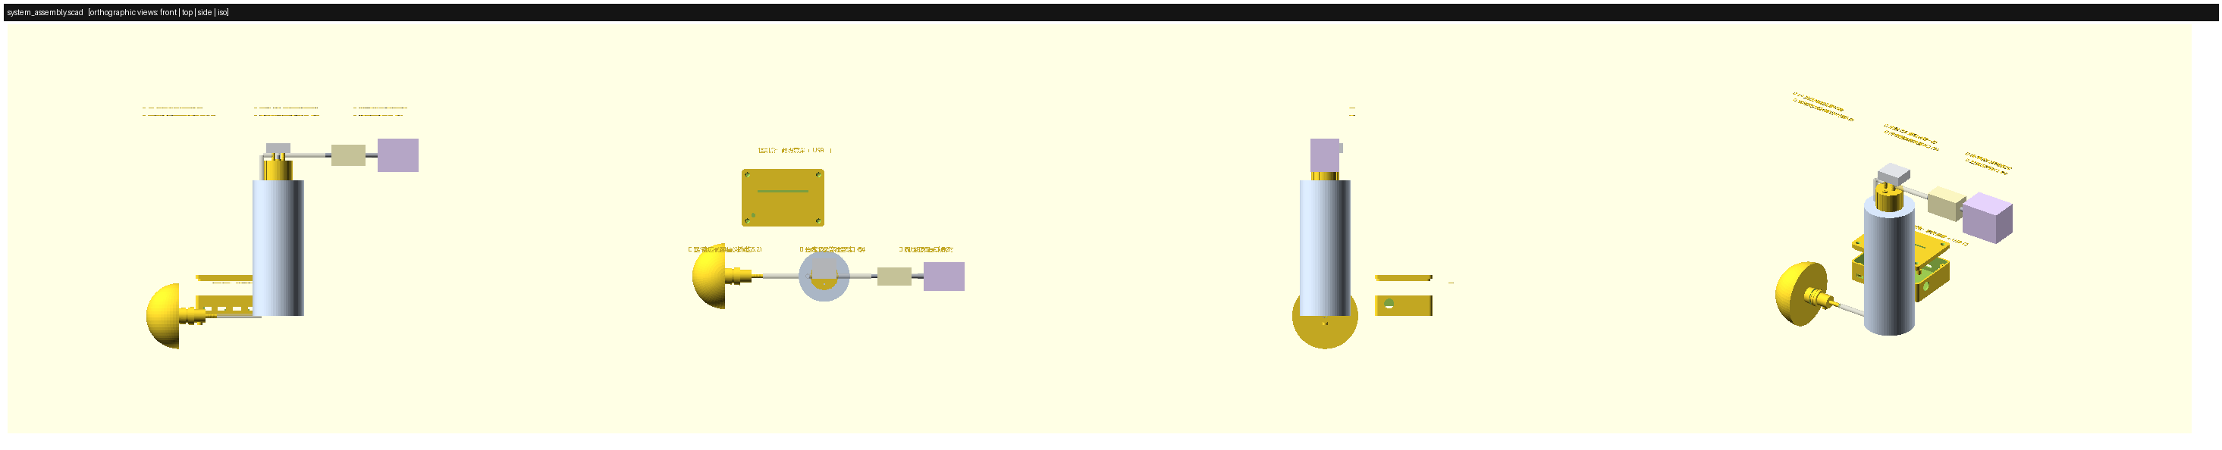
stl/views/sheet_system_assembly_v2.png
