3247786840-design/chenbai/stl/views/system_assembly_front.png

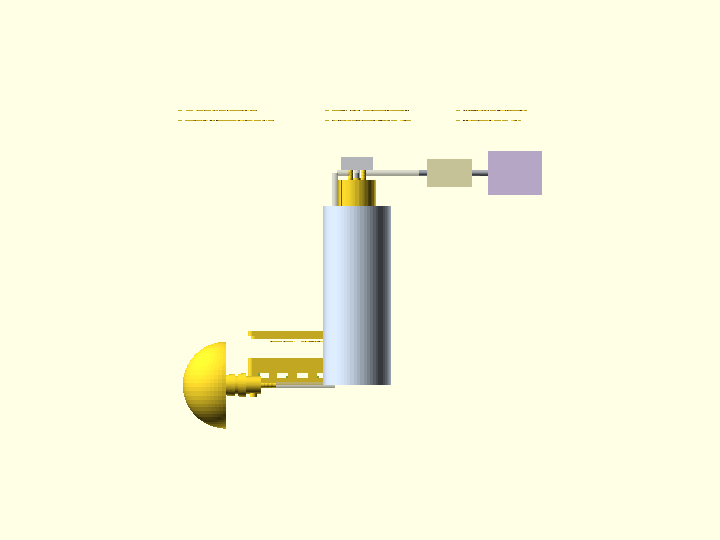
stl/views/system_assembly_front.png
