3247786840-design/chenbai/stl/views/system_assembly_iso.png

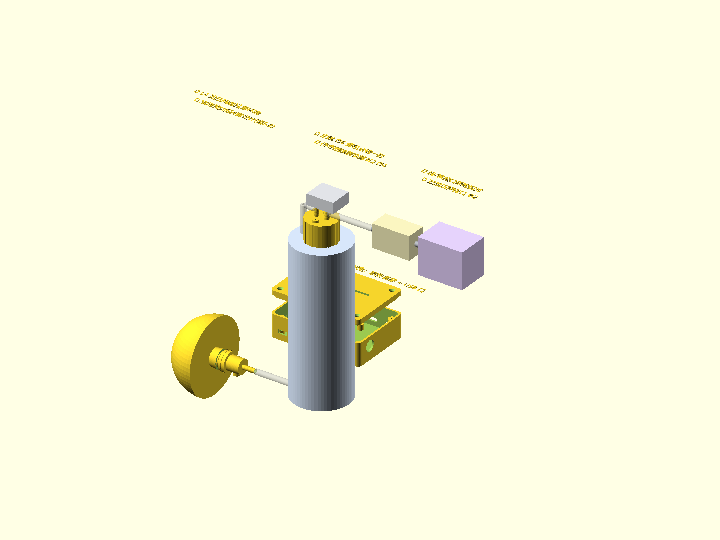
stl/views/system_assembly_iso.png
