3247786840-design/chenbai/stl/views/system_assembly_side.png

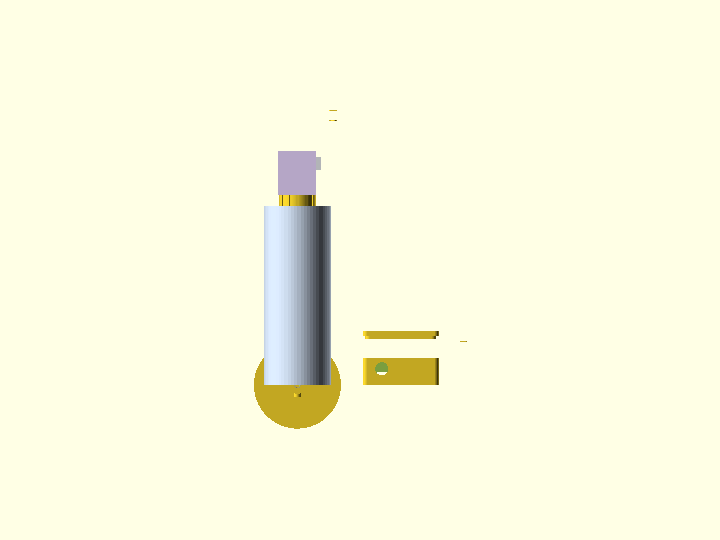
stl/views/system_assembly_side.png
