3247786840-design/chenbai/stl/views/system_assembly_top.png

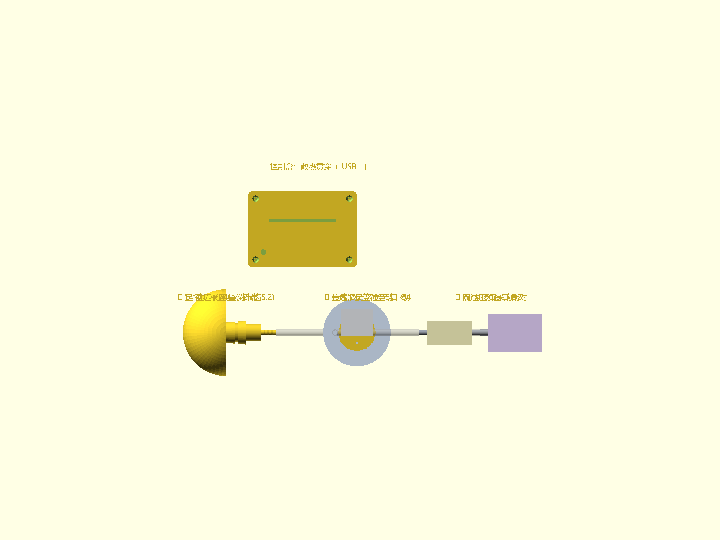
stl/views/system_assembly_top.png
