3247786840-design/chenbai/FMEA.md

# FMEA：微负压气动系统失效模式与影响分析（审查版）

> 审查立场：假设你的每一个零件都会坏、每一行代码都会错、每一次装配都会失误。
> 证据来源：本仓库数学建模仿真（`model.py` / `buffer_sweep.py`，`figs/*.png`）
> 适用范围：**纯台架验证**。任何人体接触场景下本表结论不适用，见文末生存指南。

**严重度标尺**：9–10 = 可能突破 25 mmHg 红线或造成组织损伤（若接人体）；
7–8 = 安全防线被削弱但仍有一层兜底；5–6 = 功能受损伴风险；1–4 = 功能性/体验性失效。

---

## 一、失效模式清单（20 项）

| # | 失效模式 | 潜在原因 | 对系统的影响 | 严重度 | 建议的工程改进 |
|---|---|---|---|---|---|
| 1 | **泄压阀选型错误：全流量背压过大**（起跳 25 + 背压 3 → 钳位 27.5） | 按“起跳=25”字面选型，未校核过流量能力 | 第四层形同虚设，稳态越红线（**仿真 fig3 已实测 27.53 > 25**） | **10** | 强制规范：起跳 24±0.5 mmHg，且 `K_r ≥ 4.8×10⁻⁶`（全泵流量下背压 ≤1 mmHg，钳位 ≤25）；来料每批实测起跳+过流量 |
| 2 | **泄压阀弹簧疲劳/温漂**，起跳点上移 | 弹簧应力松弛、材料蠕变、-10~40℃ 温漂 | L4 阈值漂移，可能 >25 才开 | **10** | 选恒力碟簧或做温度循环标定；预留 1 mmHg 起跳余量（24 起跳 + 1 背压 = 25）；年检更换 |
| 3 | **泄压阀阀芯被冷凝水/颗粒粘死** | 气路积水、打印残留、纤维 | L4 完全失效，电子层一旦同时失效即无底线 | **10** | 阀口朝下防积水；加 5μm 过滤片（阀上游）；台架每次实验前做“抽到 -30 验证起跳”动作 |
| 4 | **传感器短路读数恒低（隐身故障）** | 探头膜片破损短接、运放饱和 | 读数恒 -5：L1 永远认为“没抽够”→永抽；L2 永远不触发（**仿真 fig3 灰线：真实 24.7 时读数 5**） | **9** | L2 增加合理性窗口与卡死检测（读数方差≈0 超 5s 判故障，固件已实现 `FAULT_STUCK`）；L4 不依赖读数兜底 |
| 5 | **传感器掉线/断线** | 线束振动、插头松、腐蚀 | 读数浮空乱跳，L1 可能误判 | 8 | 电压窗 0.1–4.5V 判掉线 → `FAULT_SENSOR` 断电泄放（固件已实现）；锁螺丝+点胶 |
| 6 | **传感器标定漂移 ±2 mmHg** | 零点温漂、老化 | 实际 -22 时显示 -20，L2 阈值实际延后 | 8 | 每次台架实验前做大气压零点校准；用并联机械表交叉核对（见生存指南） |
| 7 | **ADC 卡死逐位不变**（不掉线、不超量程） | 芯片局部失效、固件寄存器错 | 常规滤波把它当“稳定读数”，L1/L2 同时受骗 | 8 | 原始码值连续 5s 逐位相同 → 判死（固件 `STUCK_MAX_MS`）；关键系统双传感器表决 |
| 8 | **MCU 死循环/固件跑飞** | 代码 bug、中断嵌套、内存踩踏 | L1 失效，泵持续运行 | 9 | 任务看门狗 2s（固件已实现）；**注意**：看门狗只救控制，压力时间尺度上 L4 比它快（0.24–0.87s 到红线），不可把 WDT 当压力防线 |
| 9 | **继电器触点粘连（焊死）** | 感性负载浪涌、触点电蚀 | 泵常开——文档定义的灾难场景之一；与 4、8 复合 | 9 | 触点并 RC/TVS 吸收；**架构上承认它必然发生**：由 L3+L4 兜底（仿真：三重灾难下钳位 24.70） |
| 10 | 继电器触点氧化/线圈断 → 泵不启动 | 电蚀、线圈老化 | 无负压，功能失效 | 3 | 上电自检：确认 10s 内压力达到 -10，否则报“执行器故障” |
| 11 | **电磁阀卡死在“关闭”位** | 阀芯锈蚀、异物、励磁粘连 | **断电泄放（L3）失效**：断电后系统保持原压力不回零 | 8 | 阀前加机械“断电旁通孔”（Ø1mm 泄漏孔亦可，仅牺牲少量保压）；或双阀冗余；定期动作测试 |
| 12 | 电磁阀卡死在“打开”位 | 同上（反向） | 无法密封：泵开则直冲 L4 钳位（常排气），泵停则归零——带内维持完全失效 | 8 | 同上旁通思路；自检程序检测“阀指令 vs 压力响应”一致性 |
| 13 | **气路接头在泄压阀与罩杯之间脱落** | 快插未锁、扎带松 | 该点下游失去 L4 覆盖（若阀在泵侧） | 8 | **拓扑铁律：泄压阀必须物理安装在距罩杯 <30mm 处**，其与罩杯之间只允许一段不可拆的硬管 |
| 14 | 气路接头在泵/缓冲瓶侧脱落 | 同上 | 大漏气 → 压力归零，功能失效但安全 | 3 | 扣锁式接头；管路走向避免接头受拉力 |
| 15 | 电源 12V 跌落/浪涌/反接 | 适配器劣质、插拔瞬间 | 传感器基准漂移、MCU 复位、继电器抖动 | 7 | 反接二极管 + TVS + 传感器基准用独立 LDO 并监测；MCU 复位路径必经 `safe_state()` |
| 16 | 冷凝水积聚 | 湿热气流遇冷壁 | 堵传感器取压口/泄压阀（见 #3）；电气短路 | 7 | 全气路无死角设计（OpenSCAD 注释已含）；最低点放排水阀；缓冲瓶即冷凝捕集器，定期排水 |
| 17 | **固件阈值符号/单位错误**（表压正负、kPa/mmHg 混淆） | 本项目真实高危——建模过程中即实测发生过量纲错误 | 阈值全部错位，L1/L2 集体失明 | **10** | 上电自检：要求当前大气压读数 ∈ 0±1 mmHg 才允许启动；写标定测试程序打印原始码→mmHg 对照；代码评审双人 |
| 18 | 看门狗被“在故障路径也喂狗”而失效 | 报警分支里调用 `esp_task_wdt_reset()` 时无条件喂 | 死循环藏在报警路径里永不复位 | 9 | 规则：喂狗只能出现在正常业务路径的末尾（固件中报警态喂狗是**有意**且仅限“已安全锁存”状态，评审时需确认锁存先于喂狗） |
| 19 | 密封件（O 圈）老化漏气 | 材料选错（天然橡胶）、真空脂不兼容 | 泄漏增大 → 占空比上升 → 最坏达不到目标负压 | 4 | 严禁天然橡胶（致敏+不耐油）；铂金硫化硅胶；仿真显示 ×8 劣化仅需 12.9% 占空比，余量充分 |
| 20 | 手动泄压阀/管路被误关死、软管被踩夹 | 台架现场混乱 | L4 上游被人为阻断（等效 #13） | 8 | 生存指南：泄压阀通大气口做醒目红色标识+“禁止遮挡/禁止加阀”丝印；台架巡检清单第 0 项 |

**复合故障重点（文档定义的灾难场景）**：{8 MCU 死机} ∧ {9 继电器粘连} ∧ {4 传感器短路}
→ L1、L2 全盲 → **仅 L4 拦截**。仿真结论：合格选型下钳位 **24.70 mmHg < 25 ✓**；
选型错误（#1）下钳位 **27.53 ✗**。→ **#1 是整个安全链的单点真命门，优先级最高。**

**故障树最小割集汇总**：{#1} 单独即可破防；{#3 ∧ #4 ∧ #9}、{#11 ∧ #4 ∧ #8}、{#13 或 #20} 均可绕过 L4 或让 L4 无处安放。

---

## 二、最坏情况安全生存指南（仅台架、绝不接触人体）

前提重申：本项目**未注册、未做生物学实验、未临床验证**，以下措施只用于把
“台架上的风险”压到可接受，不构成任何人体使用许可。

### A. 物理结构上“彻底绕不开”的三条铁律

1. **泄压阀贴着罩杯装**（距罩杯 <30mm 硬管直连），通大气口永远敞开、
   丝印红色“**L4-禁止遮挡**”。它与罩杯之间不许有任何快插、开关、三通。
2. **双泄压阀串联、不同厂家/批次**（成本 <30 元）：消除共因失效（#1/#2/#3 同时发生）。
   两只都按“起跳 24 + 全流量背压 ≤1”规范选型。
3. **泵速按时间定律选型**：`t = V·Δp/(P_atm·Q)` 决定电子层还有多少毫秒可用。
   泵 ≤1 L/min 时到红线 ≈2.6s，任何软件看门狗都来得及；泵 3 L/min 时只剩 0.24s，
   等于把命全押在 L4 上。

### B. 台架上的“不插电也要看得见”的监控

4. **并联一块机械真空表**（指针式，量程 0–-60 kPa，成本 <40 元）接在罩杯端——
   电子读数全部不可信时（#4/#6/#17），你还能看见真实压力。
5. **上电自检三步**（写成 checklist 贴在台架上）：
   ① 大气压下读数必须 0±1 mmHg；② 断电状态阀必须通大气（拔电看表回零速度 <0.5s）；
   ③ 手动抽到 -30 mmHg 松手 → 泄压阀必须起跳回 ≤25，每次实验前都做。
6. **带水观察**：台架罩杯改用注水模拟皮肤，负压下观察气泡/水疱征象，
   任何 >25 mmHg 持续 >10s 立即急停（拉总闸，不是按软件停止键）。

### C. 电子与代码的“就算它全错”

7. 泵供电串一个**独立硬件比较器驱动的切断 MOS**（LM393 基准 23 mmHg）——
   不经过 MCU 的第二条断电路径（固件 PIN_COMP 已留接口）。
8. 代码评审红线：喂狗位置、阈值符号、单位换算、复位路径必须四项过人眼（#17/#18）。
9. 急停物理按钮：直接断泵继电器线圈电源（NO 阀随即开），布线不经过控制板。
10. 每次改版更新本表；**任何触及 9–10 分项的改动，必须重新跑 `model.py` 仿真验证。**

### D. 明确的红线（不可谈判）

- ❌ 禁止任何人体佩戴/测试——本设计是未注册的三类医疗器械原理原型。
- ❌ 禁止拆除/旁通泄压阀做“试试极限”实验——用仿真（`buffer_sweep.py`）看曲线。
- ❌ 禁止用“代码里有限制”替代物理泄压阀——仿真已证明开环/死机时电子限制为零。

---

*版本：v1.0（随模型仿真 ver. 同步）；触发重审条件：气路拓扑、泵/阀选型、阈值、供电任一变更。*
